Open-Laboratory/kicad-components/model_kicad/IWcomponents/2305018-2.stp

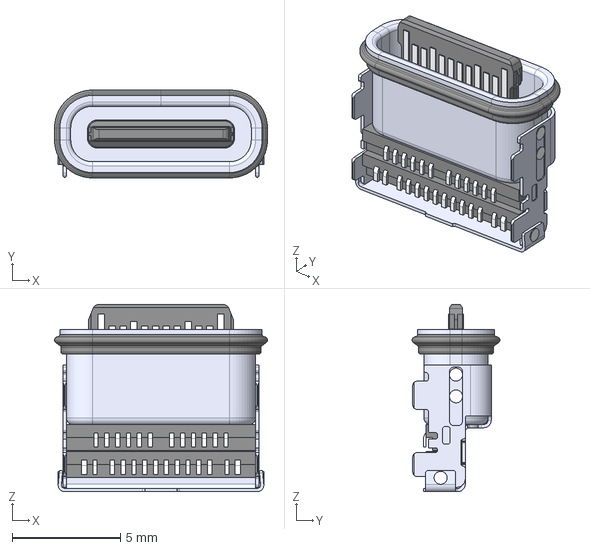
[picture p1: CAD file, 2026-09-22]
model_kicad/IWcomponents/2305018-2.stp
9.84 x 4.06 x 8.65 mm
