Open-Laboratory/kicad-components/model_kicad/IWcomponents/2495142-1.stp

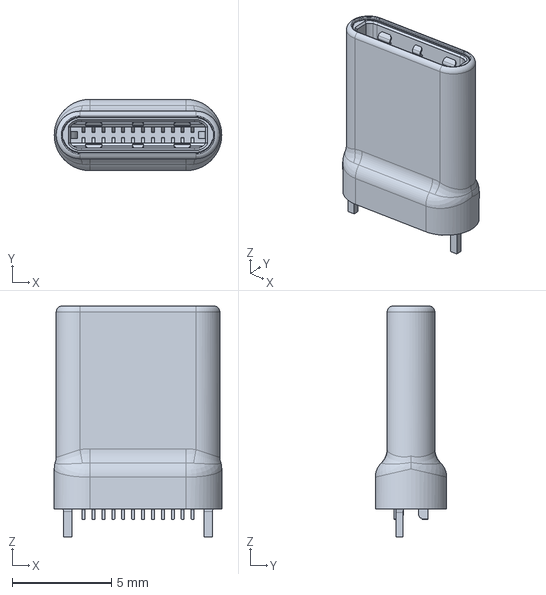
[picture p2: CAD file, 2026-09-21]
model_kicad/IWcomponents/2495142-1.stp
8.45 x 3.60 x 11.6 mm
