Open-Laboratory/kicad-components/(commit log)

2015-01-22 Начало.
2015-01-22 Поменяли описание.
2015-02-10 Добавил новые посадочные места для компонентов.
2015-04-09 Поправил ошибку у AD8494.
2015-04-18 Добавил посадочное место для multiwatt15.
2015-04-19 Отредактировал размеры контактов у некоторых элементов.
2015-04-19 Добавил новые посадочные места для конденсаторов.
2015-04-23 Добавил посадочные места для резисторов с гибкими вывовадами.
2015-04-30 Поправил посадочные места для конденсаторов.
2015-05-07 Исправил посадочне места для коденсаторов и резисторов с гибкими ногами.
2015-05-28 Поправил посадочное место MULTIWATT15.
2015-06-07 Добавил новые компоненты.
2015-06-24 Добавил счетверённый операционный усилитель.
2015-10-12 Поправил посадочное место для TO-220 с радиатором.
2015-11-05 Поправил посадочное место для SMD кнопки.
2015-12-09 Добавил одноватный резистор и сдвоенный диод Шоттки.
2016-02-07 Добавил посадочные места для эл. конденсатора и сдвоенного диода.
2016-02-19 Добавил новые посадочные места для эл. конденсаторов большой ёмкости.
2016-02-20 Добавил новый разъём pin_array_3*2.
2016-04-27 Добавил библиотеки модулей элементов в новом формате .pretty.
2016-05-05 Добавил посадочное место для энкодера с кнопкой ALPS.
2016-06-19 Поправил положение ног у двойного диода Шоттки.
2016-06-24 Добавил новые и поправил старые транзисторы.
2016-08-07 Добавил новые транзисторы 2N5551 и 2Т5401.
2016-08-26 Добавил новые компоненты (74AC08N & BSS138).
2016-08-26 Поправил компонент 74AC08N.
2016-10-10 Добавил новый компонент 3.5mm jack.
2016-10-28 Поправил назание компонента.
2016-11-23 Добавил новые посадочные места.
2016-11-24 Добавил посадочное место для SIM900D.
2016-11-25 Покаравил посадочные места для компонентов.
2016-11-25 Попаравил посадочные места для компонентов.
2016-11-30 Добавил разъём питания и jack 3.5мм.
2016-12-11 Добавил посадочное место для PLD-8.
2016-12-12 Поправил посадочные места у IDC-10, 16, 20 MS.
2016-12-16 Поправил посадочное место для SIM карты.
2017-02-19 Добавил NE555.
2017-03-14 Добавил посадочное место для керамического резистора на 10 Вт.
2017-03-29 Поправил посадочне места под компоненты.
2017-06-19 Поправил поправил посадочне места для компонентов jack3.5 и SMA-J.
2018-03-06 Добавил микросхему AD8475.
2018-03-07 Поправил микросхему AD8475.
2018-04-07 Добавил посадочные места для TSOP-24 и MSOP-10.
2018-04-07 Добавил посадочное место для кварца EPSON FA-20H.
2018-07-16 Добавил компоненты NE555 и LME49710.
2019-11-19 Добавил в библиотеку стабилизатор тока LM3406HV.
2019-11-20 Добавил новые разъёмы начерченые согласно ГОСТ ЕСКД.
2019-11-22 Добавил новый разъём начерченый согласно ГОСТ ЕСКД.
2019-11-22 Добавил компоненты REF19x, AD7888, LM22675.
2019-11-23 Поправил компонент LM22675.
2019-11-23 Добавил новые разъёмы соответствующие ГОСТ ЕСКД.
2019-11-26 Добавил посадочное место для резистора BOURNS 3224J.
2019-11-27 Добавил разъёмы DS1074-4 и DS1074-5.
2019-11-28 Добавил посадочное место SMB.
2019-11-28 Добавил посадочное место SOD-523, SOT-753.
2019-12-11 Добавил обозначение полярности на батарейный отсек TBH-18650-1A-P.
2019-12-17 Добавил новый 7*2 и поправил старые разъёмы.
2019-12-24 Добавил stm32f407vgt6.
2019-12-25 Продолжил создавать stm32f407vgt6.
2020-01-14 Добавил EPROM ST M950x0-x.
2020-01-21 Исправил ошибку в микросхеме EPROM M9050x.
2020-02-04 Создал компонент контроллера STM32F407VG6.
2020-02-05 Поправил шелкографию у некоторых компонентов.
2020-02-08 Добавил микросхему DS1338 Z/U.
2020-02-09 Поправил ST32F407VGT6.
2020-02-12 Поправил кнопку в библиотеке button.
2020-02-13 Добавил 10-ти контактный разъём оформленный согласно ЕСКД.
2020-02-13 Добавил посадочное место для светодиода с общим катодом.
2020-02-15 Добавил посадочные места для пьезоизлучателя ЗП-25 и кнопки KLS7-TS6601-XX.
2020-02-15 Поравил посадочные места нектороых компонентов.
2020-02-15 Добавил посадочное место для часового квартца MC-306.
2020-02-18 Поправил посадочное место для часовой батарейки KLS.
2020-03-06 Внёс изменения в обозначение микроконтроллера STM32F407VGT6.
2020-03-24 Добавил новый компонент DHR-62F.
2020-03-26 Добавил в библиотеку разъём питания DS1073-01-2x3.
2020-03-27 Добавил посадочне места TSSOP14 PowerPAD и SOIC8 PowerPAD.
2020-03-28 Поравил размер площадок на разъёме D-SUB 37pin тиа А.
2020-03-29 Поправил размеры отверстий у компонентов в библиотеке.
2020-04-05 Добавил обозначение для линейных стабилизаторов LM317 и LM337.
2020-05-27 Поправил посадочное место для светодиода OSRMA SFH XXXX.
2020-07-21 Добавил обозначение реле с тремя контактами.
2020-09-29 Добавли посадочное место для симфазного дросселя Wurth Electronics 744228S.
2020-10-14 Добавил обозначение для перобразователь интерфейса ADM3485.
2021-01-14 Поправил посадочные места WE_744228S и INDUCTORS_B82464G4.
2021-02-02 Добавил посадочное место для трансформатора TPG2-12.
2021-02-02 Поправил посадонче места для компонентов.
2021-02-02 Добавил посадочное место для TO-252-3.
2021-02-05 Добавил посадочное место TO-263-3.
2021-02-12 Поправил посадочные места для компонентов.
2021-02-16 Поправил посадочные места под компоненты.
2021-02-24 Добавил обозначение для тумблера MTS-102-C4-R.
2021-03-10 Добавил обозначение для микросхемы AFE4490.
2021-03-25 Добавил обозначения для сдвоенного диода и 9 контактного разъёма.
2021-04-06 Добавил обозначение для ADG849.
2021-04-07 Добавил посадочные места SOT323 и RHA S-PVQFN-N40.
2021-04-12 Поправил посадочные места у компонентов.
2021-04-13 Добавил посадочные места для угловых разъёмов WF-2R, WF-3R, WF-4R.
2021-04-13 Поправил посадочные места для угловых разъёмов WF-2R, WF-3R, WF-4R.
2021-04-14 Добавил обозначение для разъёма с 11 контактами.
2021-04-16 Поправил посадочне места у компонентов.
2021-04-27 Добавил посадочные места для светодиодов.
2021-04-29 Добавил посадочное место для тумблера MTS-102-C4-R.
2021-05-25 Добавил посадочное место для трансформатора ТПГ-112 2хXXВ.
2021-06-28 Добавил обозначение для тумблера MTS-202-C4.
2021-08-05 Добавил новые обозначения для фотодиода и светодиода.
2021-08-09 Добавил новое обозначение для светодиода.
2021-09-09 Добавил посадочное место для кварца HC-49U.
2021-10-19 Добавил посадочное место для трансформатора ТП-112-11.
2021-10-26 Добавил посадочное место для тумблера MTS-202-C4.
2021-10-27 Поправил посадочное место для тумблера MTS-202-C4.
2021-10-28 Добавил ВЧ разъём BNC-KWE.
2021-11-03 Добавил посадочное место для реле HFD4/12-SR.
2021-11-09 Поправил посадочное место для TO-252.
2021-11-15 Добавил обозначение для BAV99.
2022-02-28 Добавил обозначение для К544УД2.
2022-03-11 Добавил библиотеку реле и новые посадочне места.
2022-03-14 Поправил посадочные места для резисоров с выводами.
2022-03-21 Добавил библиотеку с реле.
2022-03-24 Добавил обознаение для транзистора 2SK208.
2022-03-31 Поправил обозначение для полевого транзистора 2SK208.
2022-04-01 Поправил посадочное место 0604.
2022-04-26 Поправил обозначения линейныйх стабилизаторов.
2022-07-05 Добавил библиотеку для микроконтроллеров.
2022-07-07 Добавил обозначение для антены PRO-OB-440.
2022-07-11 Добавил новые обозначения в библиотеку.
2022-07-14 Добавил в проект две библиотеки. Одна для преобразователей USB/UART/RS485 и подобного, а другая для микросхем контроля заряда аккумуляторов.
2022-07-20 Поправил бозначение контроллера заряда.
2022-07-25 Добавил билиотеку для dc/dc преобразователей.
2022-08-02 Добавил новые обозначения для компонентов.
2022-08-10 Добавил новые посадочные места для микросхем.
2022-08-11 Добавил посадочное место VQFN-24..
2022-08-22 Добавил посадочное место для силовой индуктивности WE.
2022-08-24 Добавил посадочное место для дросселя.
2022-11-03 Поправил посадочное место для разъёма USB.
2022-12-06 Добавли новое посадочное место для разъёма.
2022-12-22 Поправил посадочные места разъёмов серии IDC-xxMS.
2023-01-31 Конвертировал старые библиотеки символов в новые.
2023-01-31 Добавил BL7142WH в библиотеку символов.
2023-03-21 Добавли посадочные места для конденсатора диаметром 8 мм.
2023-03-24 Добавил обозначение для TL432.
2023-06-15 Поправил размеры разъёма USB-B.
2023-12-19 Поправил ошибки у компонентов.
2023-12-26 Добавил новые посадочные места и поправил старые.
2025-02-07 Добавил монтажное отверстие 3.2мм и поправил PSA12-11.
2025-02-11 Поправил толщину линий и размеры шрифта у компонентов.
2025-02-12 Удалил из библиотеки повторяющиеся компоненты, создал отдельную библиотеку для кварцев, поправил некоторые компоненты.
2025-05-22 Добавил новую библиотеку для часов реального времени RTC.
2026-05-08 Добавил обозначения для транзисторов LSK489 и BF862.
2026-09-21 Добавил в библиотеку разъёма USB Type C Plug TE_2495142-1 вместе с моделью.
    [2495142-1.stp]
2026-09-22 Добавил обозначение, посадочное место и модель разъёма USB Type C Receptacle TE 2305018-2.
    [2305018-2.stp]
2026-09-23 Поправил обозначения у USB Type C.
2026-10-20 Добавил SMD контакт и обозначение для 12-ти контактного разъёма.
2026-11-09 Поправил посадочное место для разъёма USB Type-C Plug TE 2495142-1.
